epsilonrt/Hmi4DinBox/extras/firmware/README.md

# Hmi4DinBox Firmware

For now the firmware uses the framework [AvrIO](https://github.com/epsilonrt/avrio), 
it should one day carry out the porting to the Arduino framework, one day...

As it is, you must flash the firmware using the 
[hmi4dinbox-firmware.hex](hmi4dinbox-firmware.hex) file in this directory 
and using avrdude (explain in the [wiki](https://github.com/epsilonrt/Hmi4DinBox/wiki)).
