epsilonrt/Hmi4DinBox/extras/images/pcb-bot.jpg

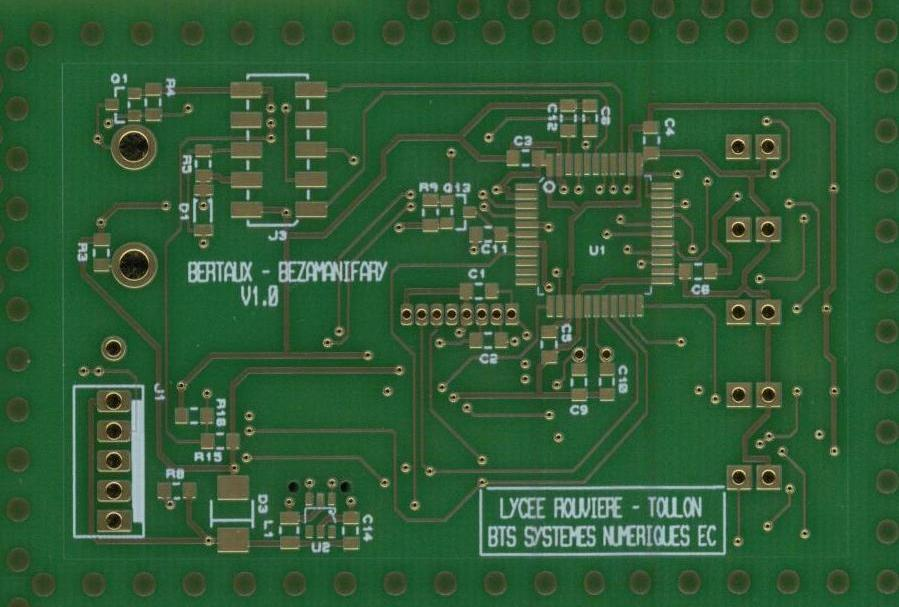
extras/images/pcb-bot.jpg
