epsilonrt/Hmi4DinBox/extras/images/pcb-top.jpg

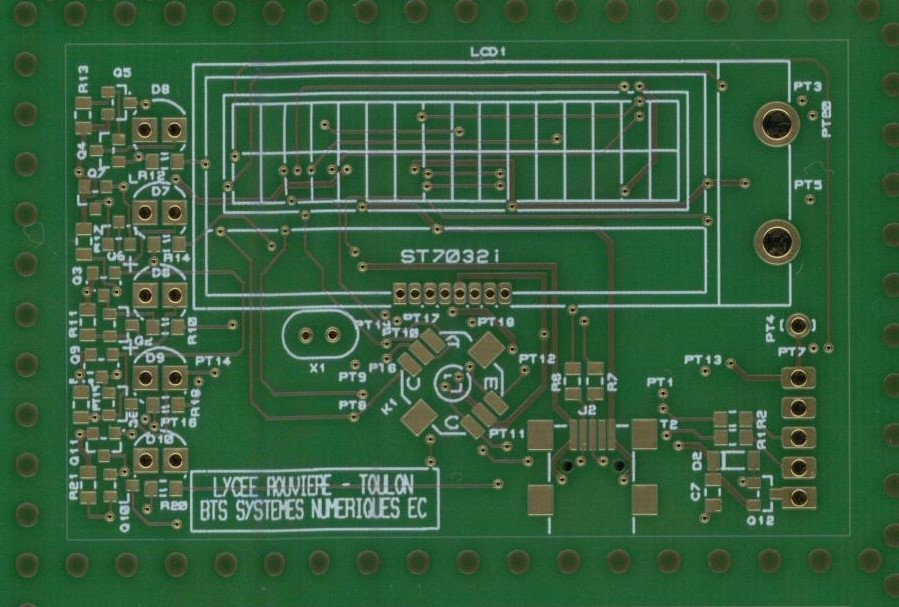
extras/images/pcb-top.jpg
