epsilonrt/Hmi4DinBox/extras/images/Requirement_Diagram.png

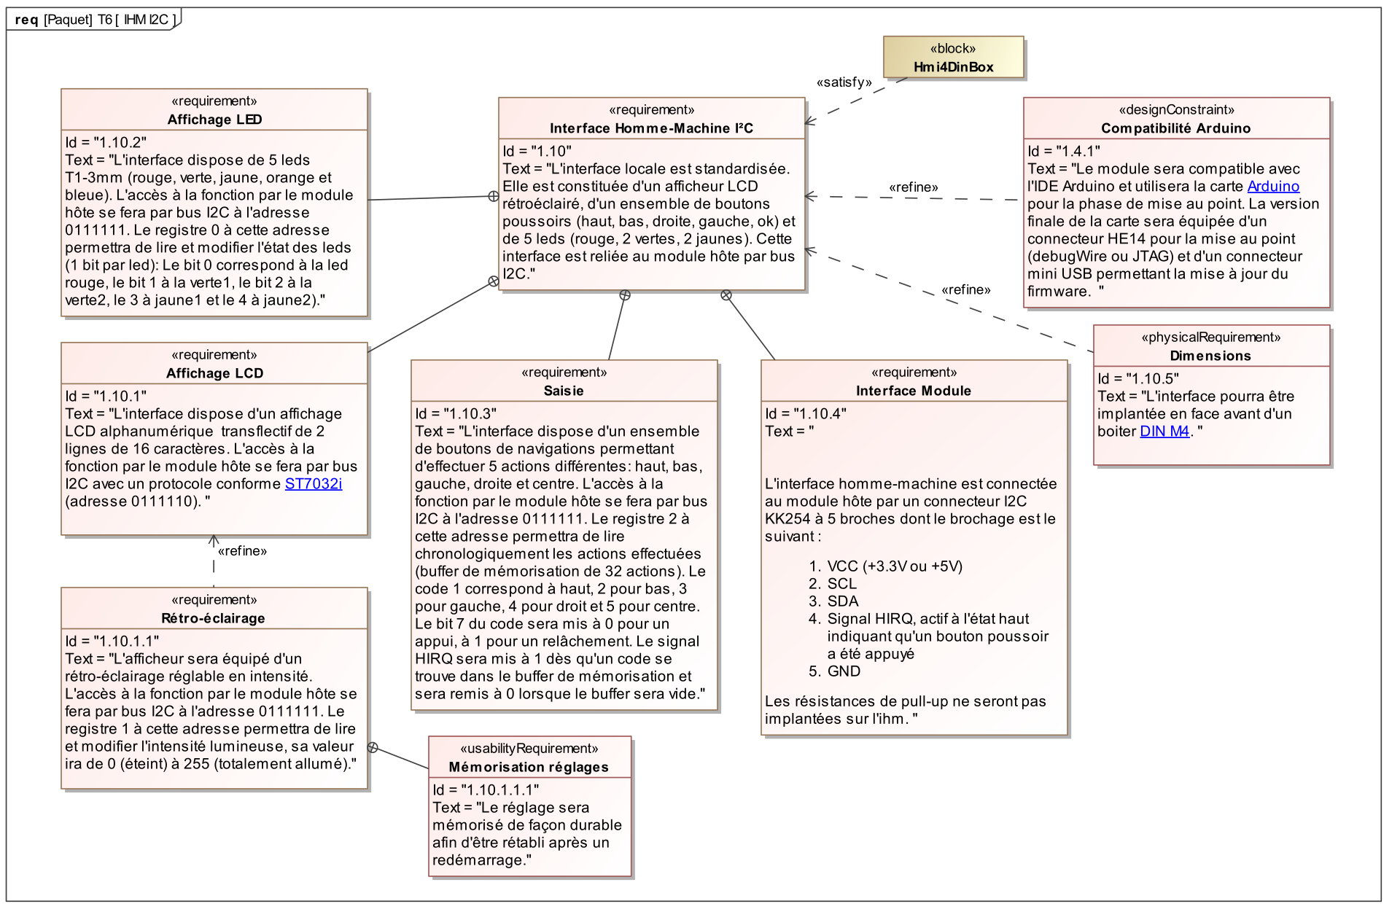
extras/images/Requirement_Diagram.png
