epsilonrt/Hmi4DinBox/extras/hardware/hmi4dinbox-bom.ods

Category | Quantity | Reference | Value | Order Code | Package
Resistors | 7 | R1,R2,R11,R13,R17,R19,R21 | 300 |  | 0805
Resistors | 1 | R3 | 33 |  | 0805
Resistors | 2 | R4,R9 | 1M |  | 0805
Resistors | 1 | R5 | 10k |  | 0805
Resistors | 2 | R6,R7 | 22 |  | 0805
Resistors | 1 | R8 | 100k |  | 0805
Resistors | 5 | R10,R12,R14,R18,R20 | 12k |  | 0805
Resistors | 2 | R15,R16 | 47k |  | 0805
Capacitors | 4 | C1,C2,C11,C14 | 1uF |  | 0805
Capacitors | 6 | C3-C6,C8,C12 | 100nF |  | 0805
Capacitors | 1 | C7 | 10uF |  | 0805
Capacitors | 2 | C9,C10 | 22pF |  | 0805
Integrated Circuits | 1 | U1 | ATMEGA32U4 |  | TQFP44-12X12MM
Integrated Circuits | 1 | U2 | USBLC6-4 |  | SOT457
Transistors | 1 | Q1 | BSS 316N |  | SOT23
Transistors | 10 | Q2-Q11 | BC846B |  | SOT23
Transistors | 2 | Q12,Q13 | DMG2305UX |  | SOT23
Diodes | 1 | D1 | 1N4148 |  | SOD123
Diodes | 1 | D2 | BZT52C6V8S-7 |  | SOD123
Diodes | 1 | D3 | SMBJ5.0CA |  | SMB
Diodes | 1 | D6 | LED-RED |  | LED-RED
Diodes | 2 | D7,D10 | LED-YELLOW |  | LED-YELLOW
Diodes | 2 | D8,D9 | LED-GREEN |  | LED-GREEN
Miscellaneous | 1 | J1 | CONN-5 |  | CONN-5-KK254
Miscellaneous | 1 | J2 | 65100516121 |  | MINI-USB
Miscellaneous | 1 | J3 | CONN-2X5 |  | CONN-2X5-HE14-SMD
Miscellaneous | 1 | K1 | SKRHAAE010 |  | NAV-SKRHAAE010
Miscellaneous | 1 | L1 | MH2023-300Y |  | IND805
Miscellaneous | 1 | LCD1 | MCCOG21605B6W-SPTLYI |  | LCD-MCCOG21605B6W
Miscellaneous | 19 | PT1-PT3,PT5-PT20 | TEST-POINT |  | CONN-1-VIA
Miscellaneous | 1 | PT4 | TEST-POINT |  | TP-TAB37800868
Miscellaneous | 1 | X1 | 16M |  | HC-46X
