epsilonrt/Hmi4DinBox/extras/hardware/hmi4dinbox-sch.pdf

0

1

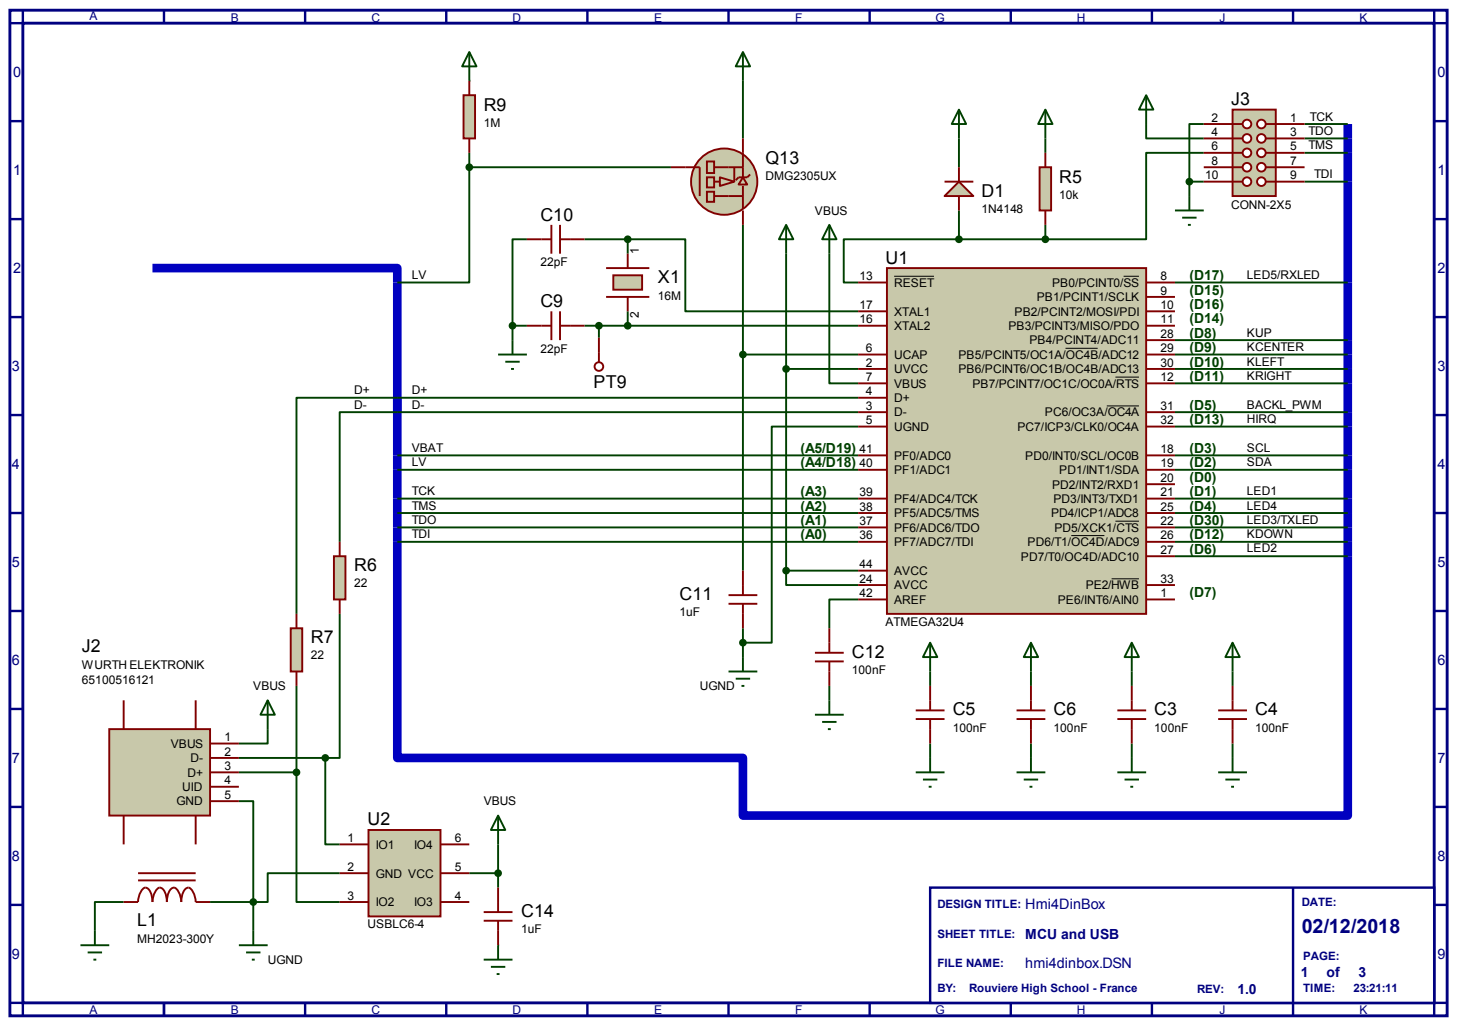
[picture p6: page 1]

0

1

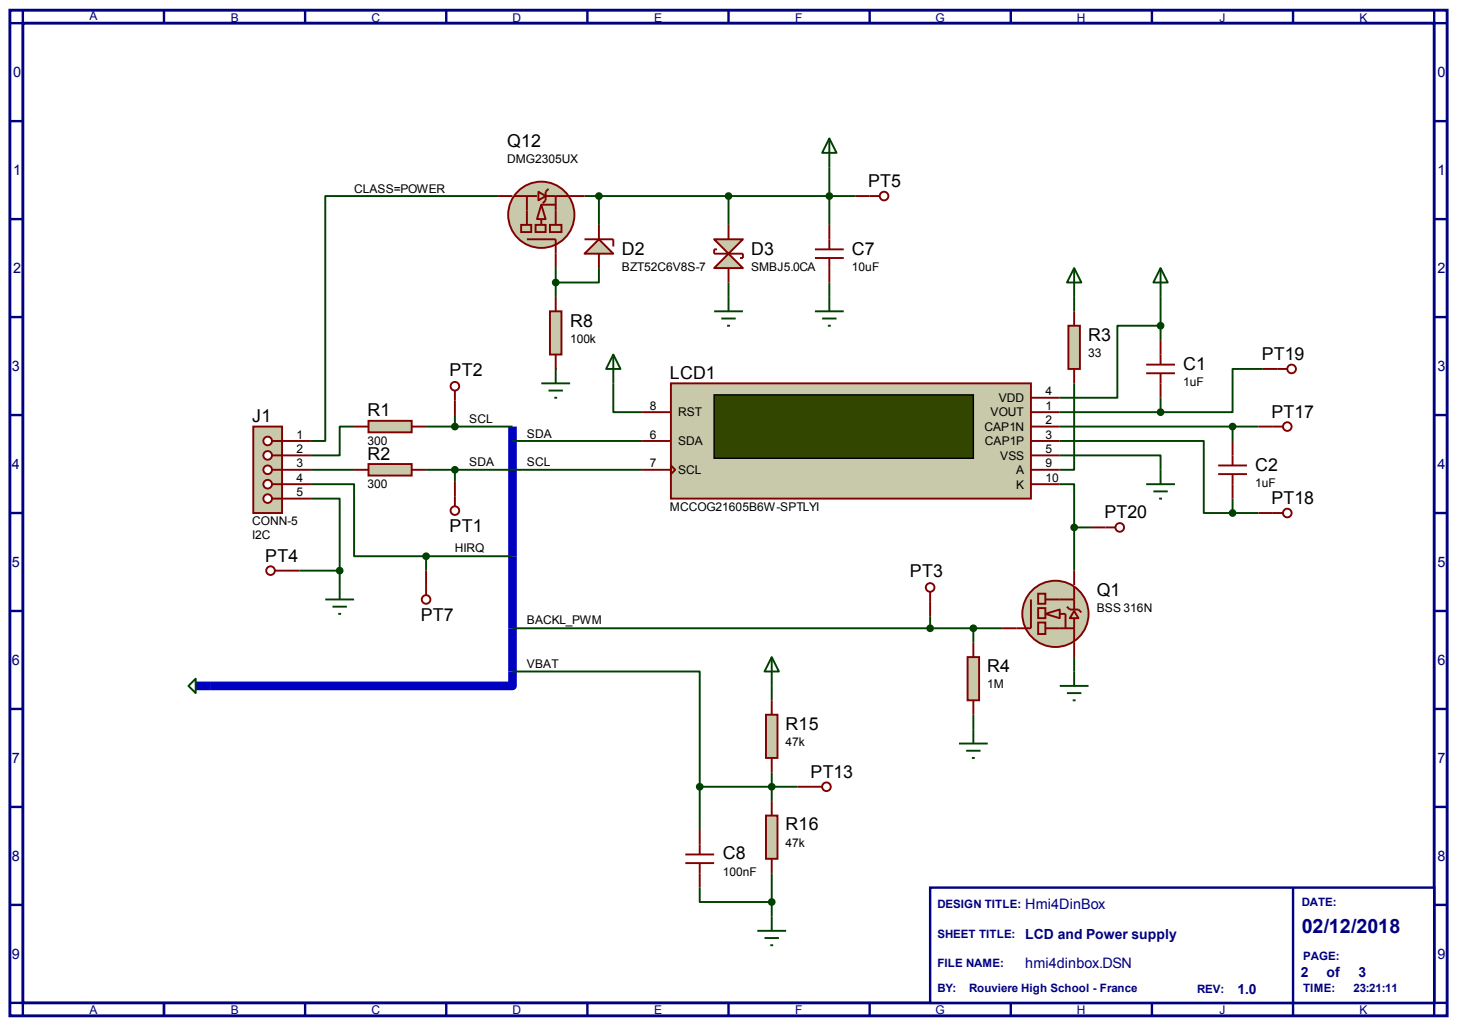
[picture p7: page 2]

LCD and Power supply

0

1

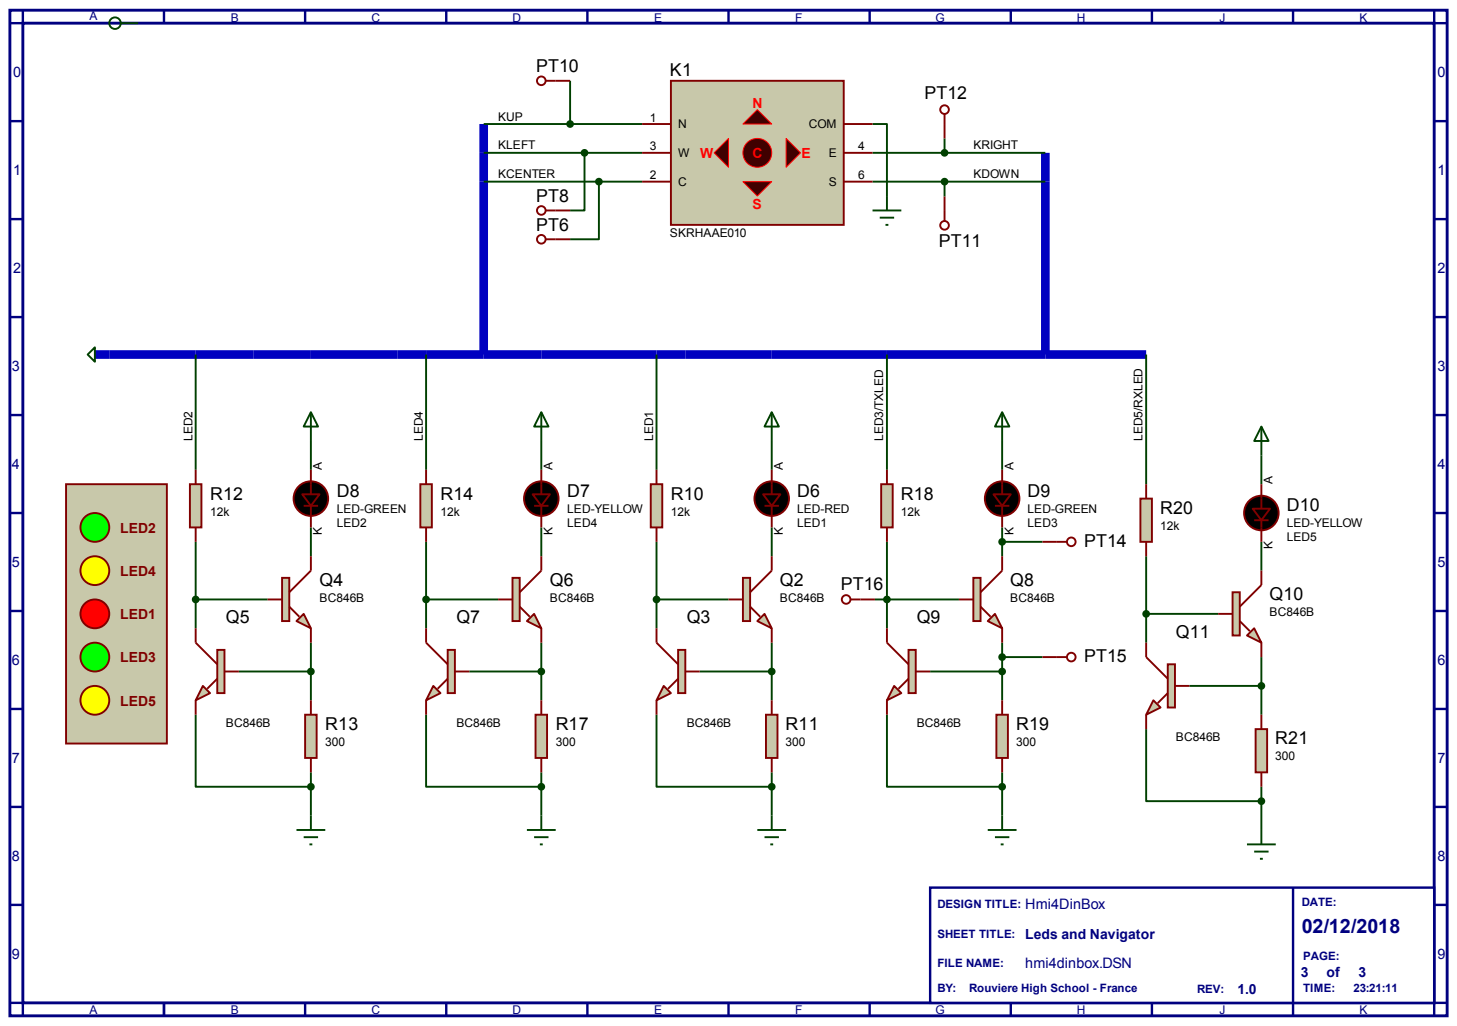
[picture p8: page 3]
