epsilonrt/Hmi4DinBox/extras/hardware/hmi4dinbox-pcb.pdf

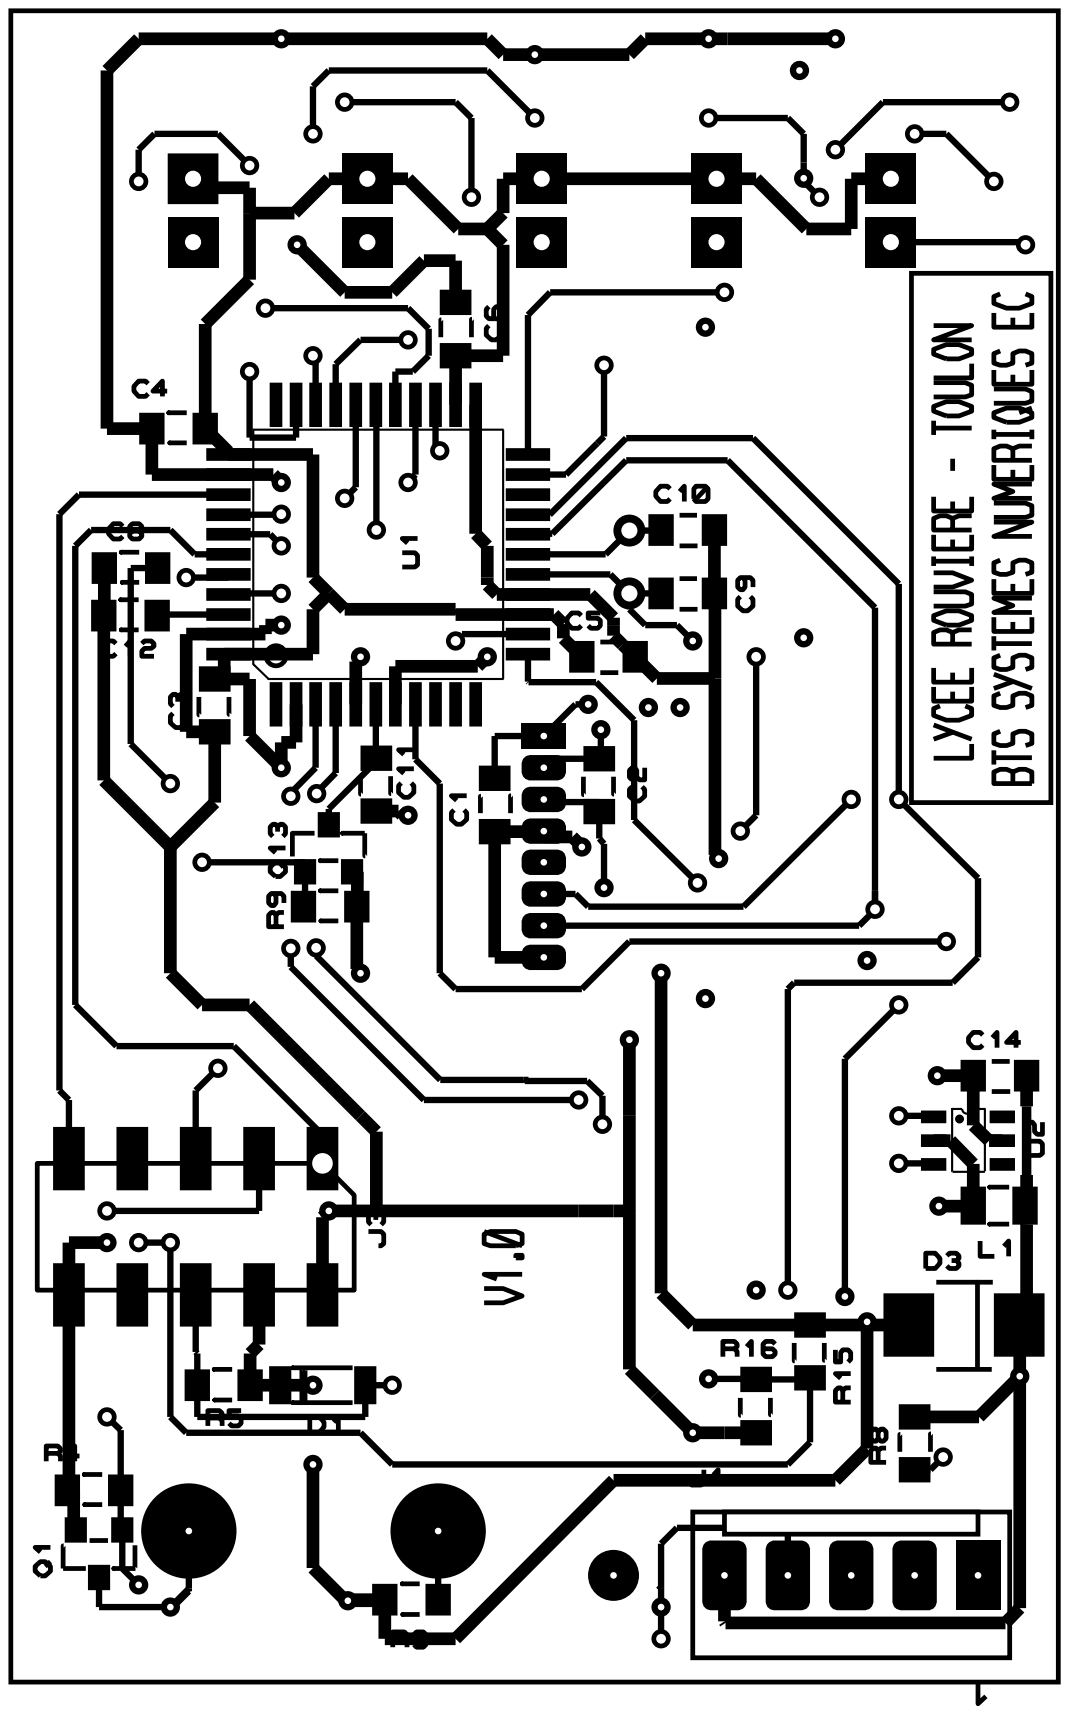
[picture p9: page 1]

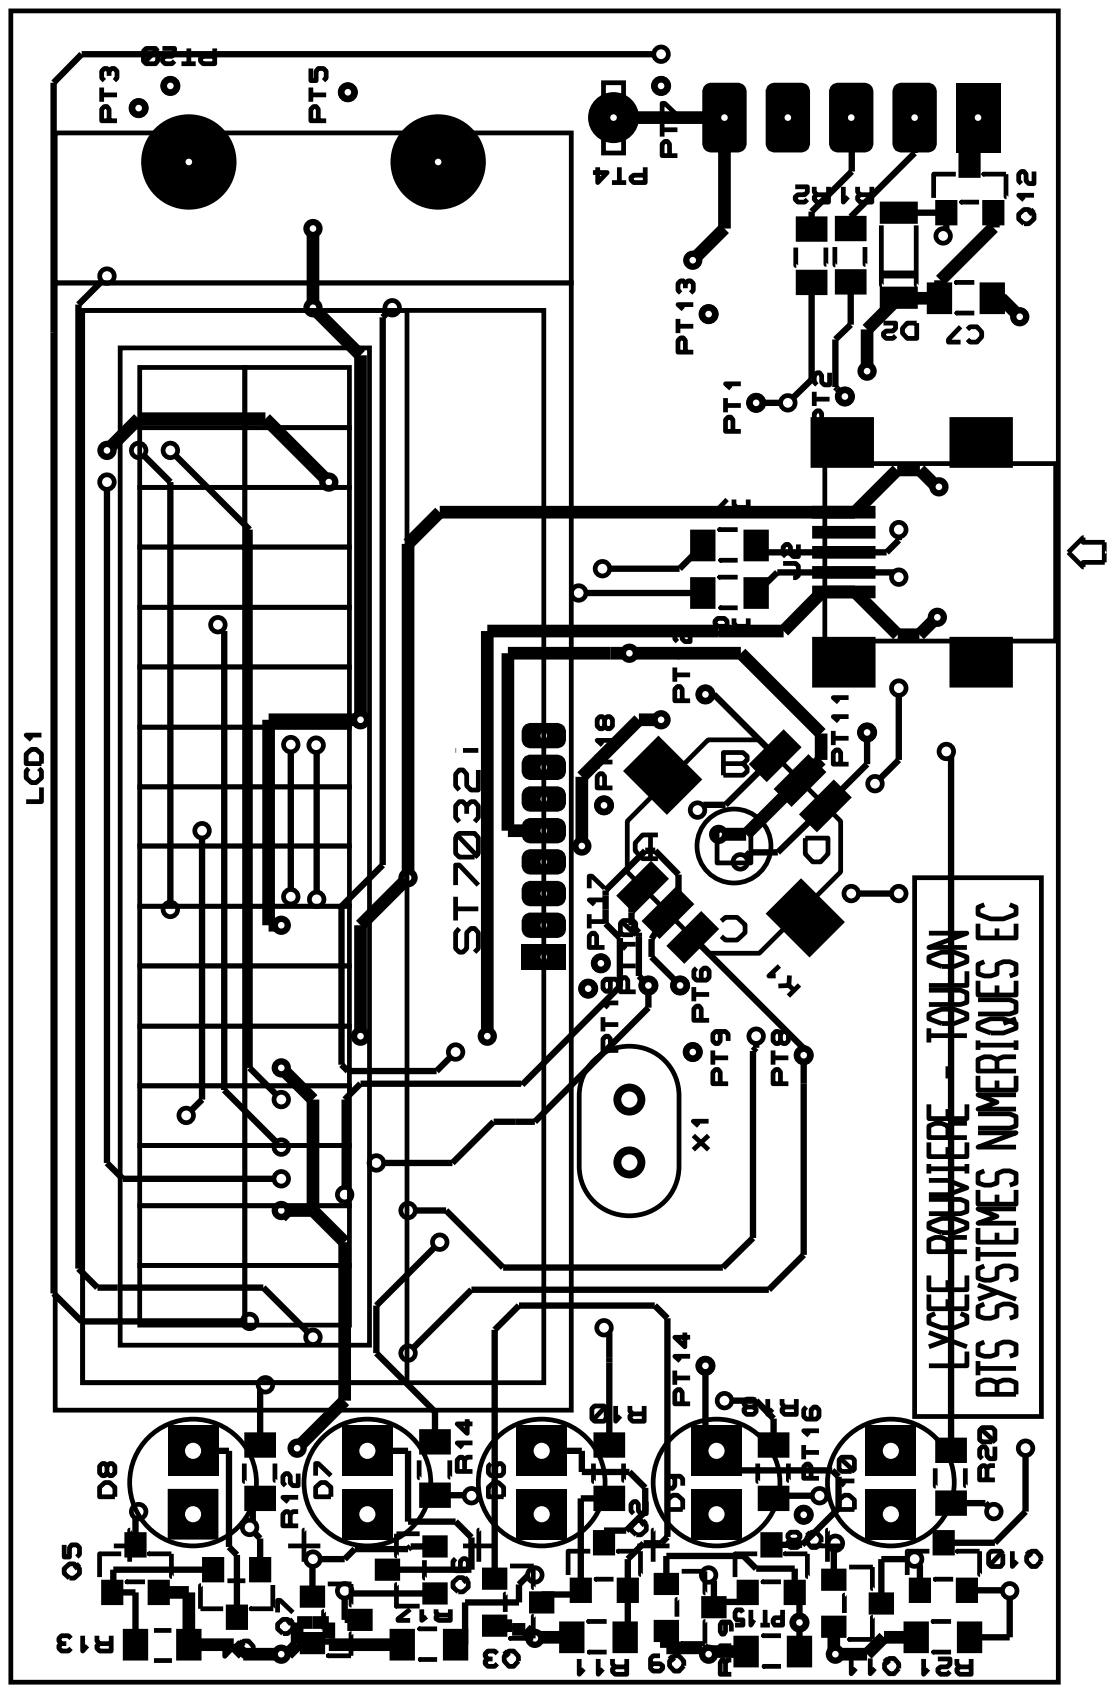
[picture p10: page 2]
