epsilonrt/Hmi4DinBox/extras/hardware/hmi4dinbox-layout.pdf

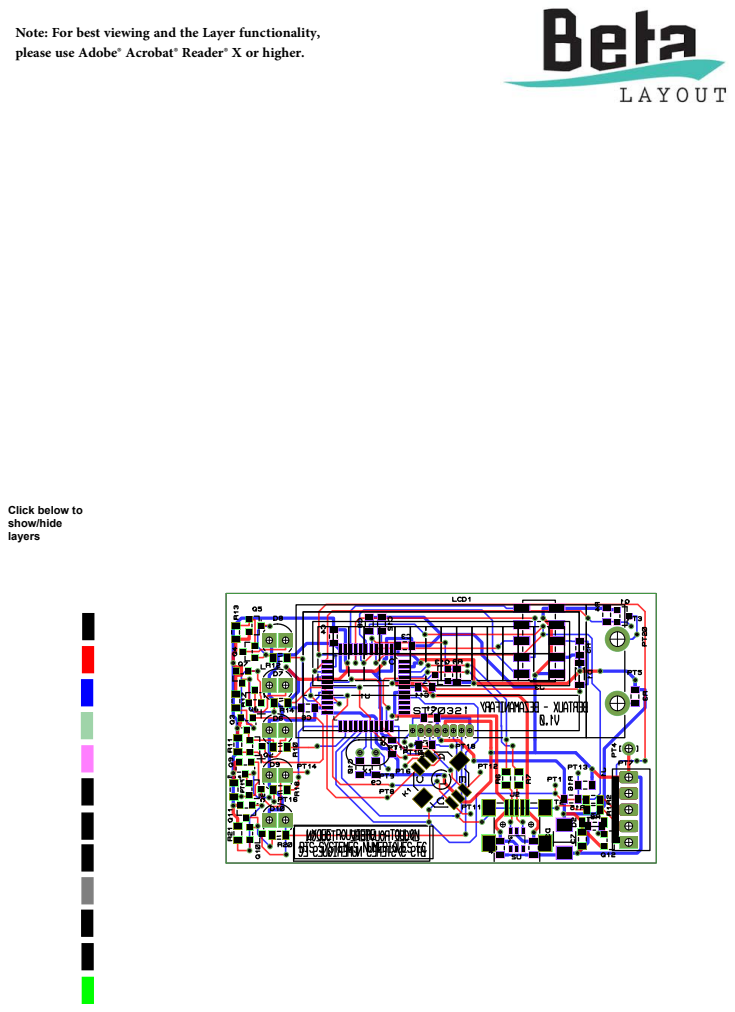
[picture p11: page 1]

Note: For best viewing and the Layer functionality,
please use Adobe® Acrobat® Reader® X or higher.
