epsilonrt/Hmi4DinBox/(list of files, drawings)

Other design files:
extras/hardware/proteus/hmi4dinbox.DSN
extras/hardware/proteus/hmi4dinbox.LYT
