epsilonrt/Hmi4DinBox/examples/BacklightDemo/BacklightDemo/BacklightDemo.ino

// Hmi4DinBox Class: LCD Backlight Example
// by epsilonrt <https://github.com/epsilonrt>

// How to control the backlight ?

// Created 18 may 2018

// This example code is in the public domain.
#ifdef __unix__
#include <Piduino.h>  // All the magic is here ;-)
#else
// Defines the serial port as the console on the Arduino platform
#define Console Serial
#endif

#include <Hmi4DinBox.h>

const int lcdContrast = 34; // 24 if you use a 5V power supply, 34 if you use a 3.3V power supply
const bool lcdBoost = true; // false if you use a 5V power supply, true if you use a 3.3V power supply
const int hirqPin = 7;
Hmi4DinBox hmi (hirqPin);

byte bl;
void printBacklight ();

void setup() {

  Console.begin (115200);
  Wire.begin(); // change this if you use another I2C port or if you use non standard I2C pins
  if (!hmi.begin (lcdContrast, lcdBoost)) {

    Console.println("hmi.begin() failed !");
    exit (1); // HMI failed to start !
  }

  // read value stored in EEPROM.
  bl = hmi.backlight.read();

  // print this value
  hmi.lcd.clear();
  hmi.lcd.print ("Backlight");
  printBacklight();
}

void loop() {

  if (hmi.keyb.available()) { // check if keys are available

    if (hmi.keyb.pressed()) {
      byte key = hmi.keyb.key(); // get the next key

      if ( (key == KUP) || (key == KDOWN)) { // if key UP or DOWN

        if (key == KUP) {

          bl += 8; // UP for increase
        }
        else {

          bl -= 8;  // DOWN for decrease
        }

        // change value and print
        hmi.backlight.write (bl);
        printBacklight();
        hmi.led.toggle (LED_GREEN1);
      }
    }
  }
}

void printBacklight () {

  hmi.lcd.setCursor (0, 10);
  hmi.lcd.print (bl);
  hmi.lcd.print ("  ");
}
