epsilonrt/Hmi4DinBox/extras/firmware/src/src/backlight.h

#ifndef _HMI4DINBOX_BACKLIGHT_H_
#  define _HMI4DINBOX_BACKLIGHT_H_
/* ========================================================================== */

/* LCD_BACKLIGHT ============================================================ */
#  include <avrio/defs.h>
#  include <avr/io.h>

/* inline public functions ================================================== */
/*
 * Initialise la ressource matérielle (timer PWM de préférence) utilisée par
 * le module lcd (rétroéclairage).
 * A modifier en fonction du timer et de la sortie utilisée.
 */
INLINE void
vHmiBacklightInit (void) {

  DDRC |= _BV (6);  /* PC6 (OC3A) en sortie */
  /*
   * Mode PWM Phase correcte (1),
   * Clear OC on compare match
   * FCLK / 8
   * F = FCPU / (8 * 510) = 1.9 KHz pour 8 MHz
   */
  TCCR3A = 0b10000001;
  TCCR3B = 0b00000010;
}

/*
 * Modifie le niveau de rétroéclairage du LCD
 * @param ucValue niveau entre 0 et 255
 */
INLINE void
vHmiBacklightSet (uint8_t ucValue) {

  OCR3AL = ucValue;
}

/* ========================================================================== */
#endif /* _HMI4DINBOX_BACKLIGHT_H_ */
