epsilonrt/Hmi4DinBox/extras/firmware/src/src/hirq.h

#ifndef _HMI4DINBOX_HIRQ_H_
#  define _HMI4DINBOX_HIRQ_H_
/* ========================================================================== */

/* HIRQ  ==================================================================== */
#  include <avrio/defs.h>
#  include <avr/io.h>

#define HIRQ  _BV(7)

/* inline public functions ================================================== */
  
// ---------------------------------------------------------------------------
INLINE void 
vHmiHirqSet (void) {

  PORTC |= HIRQ;
}

// ---------------------------------------------------------------------------
INLINE void 
vHmiHirqClear (void) {

  PORTC &= ~HIRQ;
}

// ---------------------------------------------------------------------------
INLINE void 
vHmiHirqInit (void) {

  DDRC |= HIRQ;
  vHmiHirqClear();
}

/* ========================================================================== */
#endif /* _HMI4DINBOX_HIRQ_H_ */
