epsilonrt/Hmi4DinBox/(commit log)

2018-12-02 Update doc and schematics
    [hmi4dinbox-bom.ods, hmi4dinbox.DSN]
2018-12-02 Adds firmware sources
    [hmi4dinbox.DSN, hmi4dinbox.LYT]
2018-12-03 Reorganization of folders
    to be compatible with the hierarchy of Arduino libraries
    [hmi4dinbox-bom.ods, hmi4dinbox.DSN, hmi4dinbox.LYT]
2018-12-03 Adds WireHmi files
2018-12-09 Fixes firmware keyboard bug
    [hmi.c]
2023-06-02 Fixes warning for @ArduinoBot
2023-06-02 Update library version for @ArduinoBot
2025-01-15 Removed Wire.begin() from WireLcd
